PraveenKumarM-ECE/Micro-Fluid-Dispenser/Images/IMG20251128144413.jpg

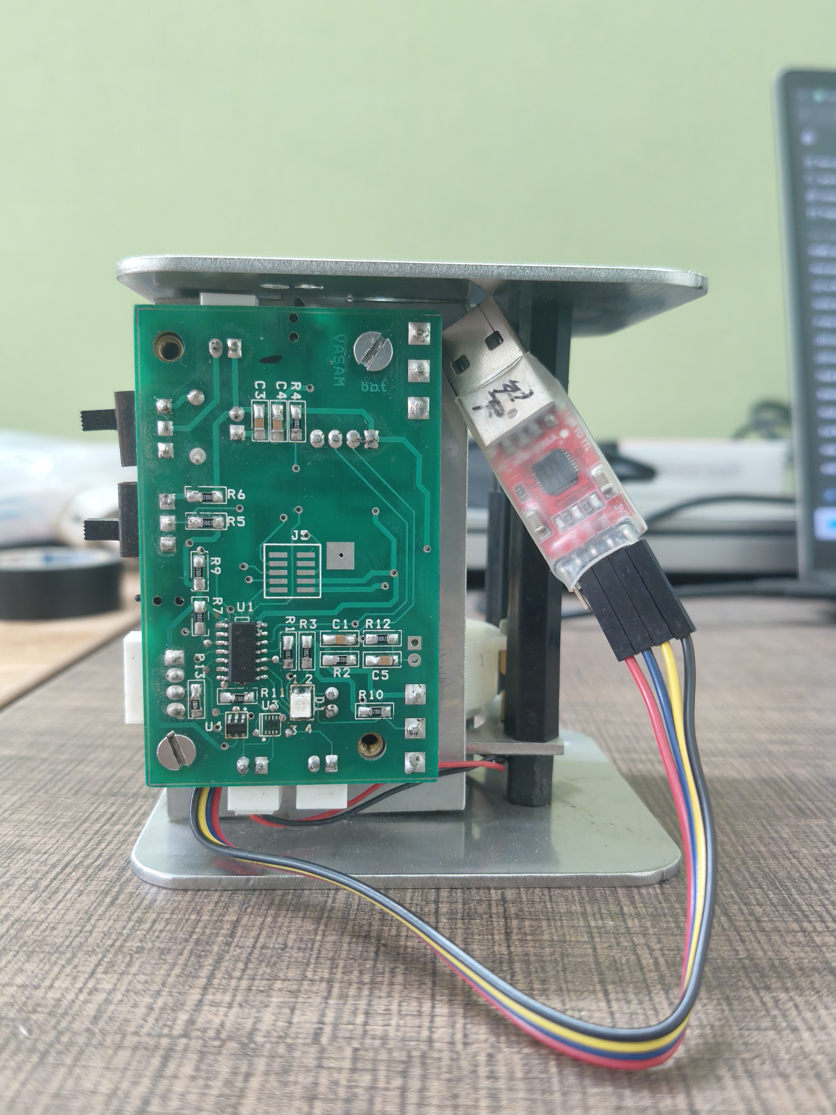
Images/IMG20251128144413.jpg
