PraveenKumarM-ECE/Micro-Fluid-Dispenser/Images/IMG20251128144513.jpg

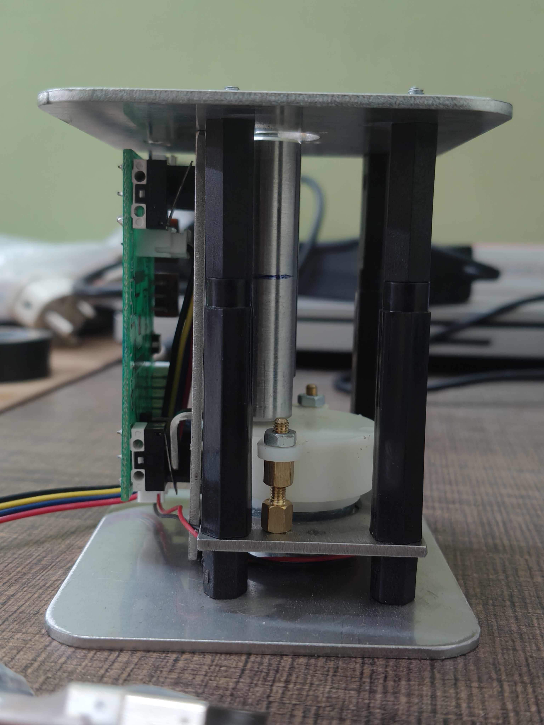
Images/IMG20251128144513.jpg
