PraveenKumarM-ECE/Micro-Fluid-Dispenser/Schematic/Schematic.pdf

### ESP32

# PA3 GND

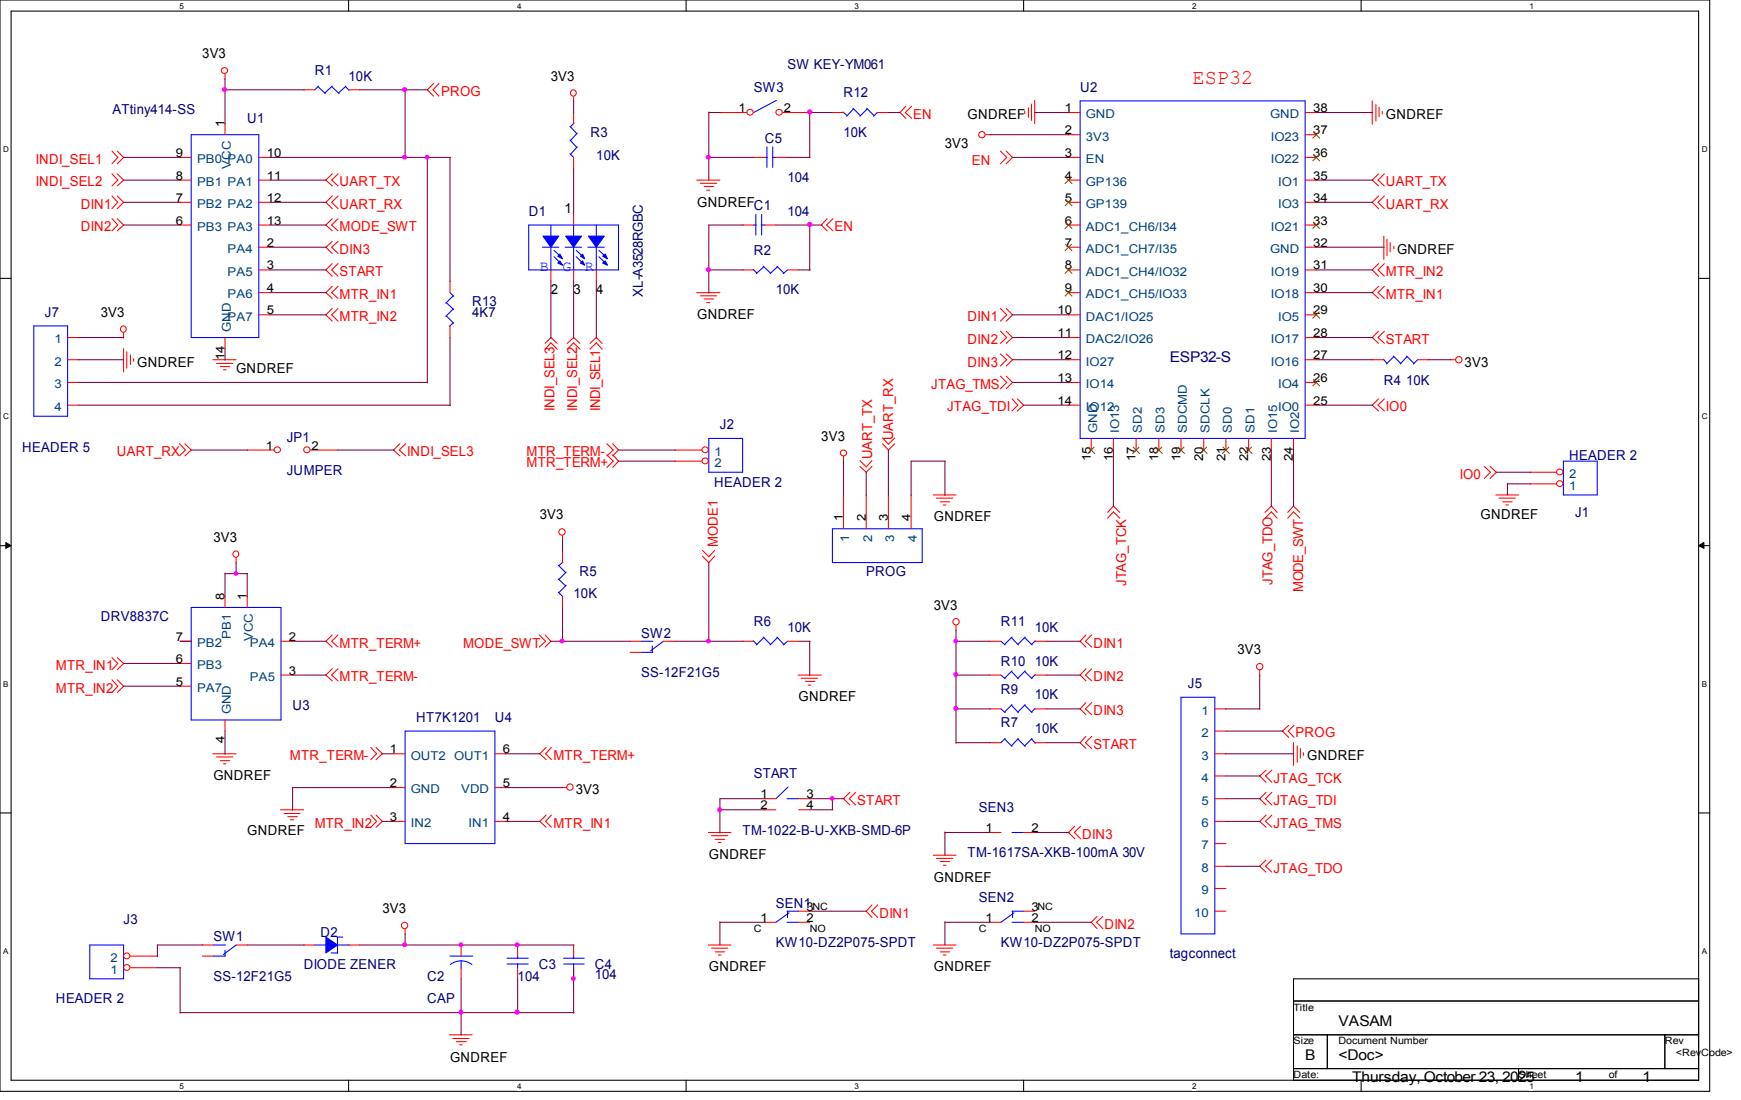
[picture p10: page 1]

Size B | Document Number | Rev

Date: | Sheet of
